JeremyV2014/PlantLifeMonitoringSystem/Diagrams/Breadboard_Top_View.jpg

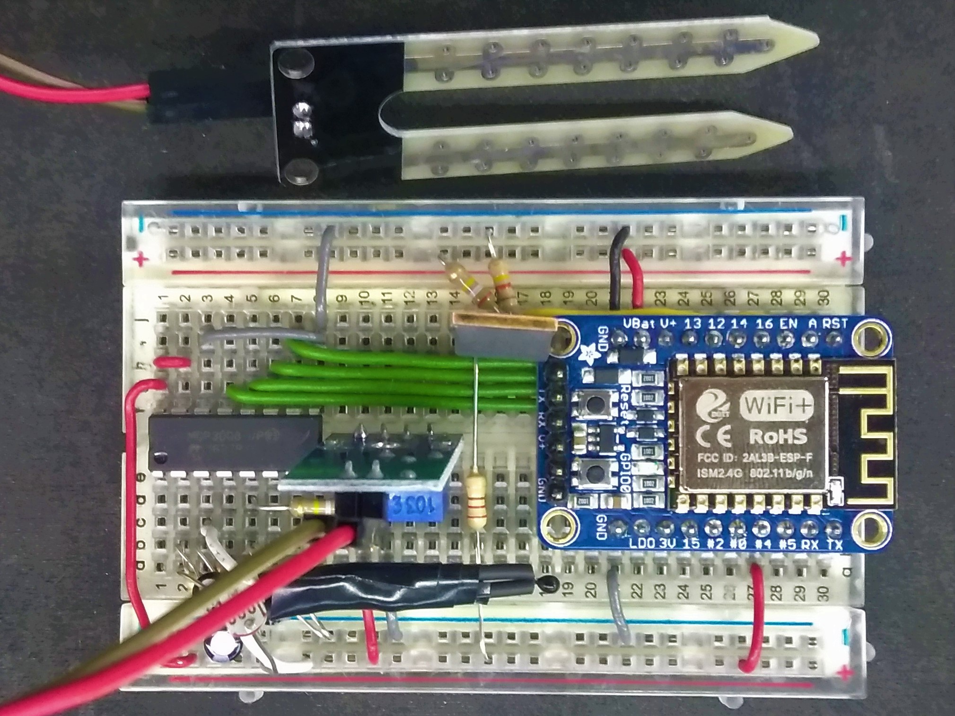
Diagrams/Breadboard_Top_View.jpg
