JeremyV2014/PlantLifeMonitoringSystem/Diagrams/Breadboard_Isometric_View.jpg

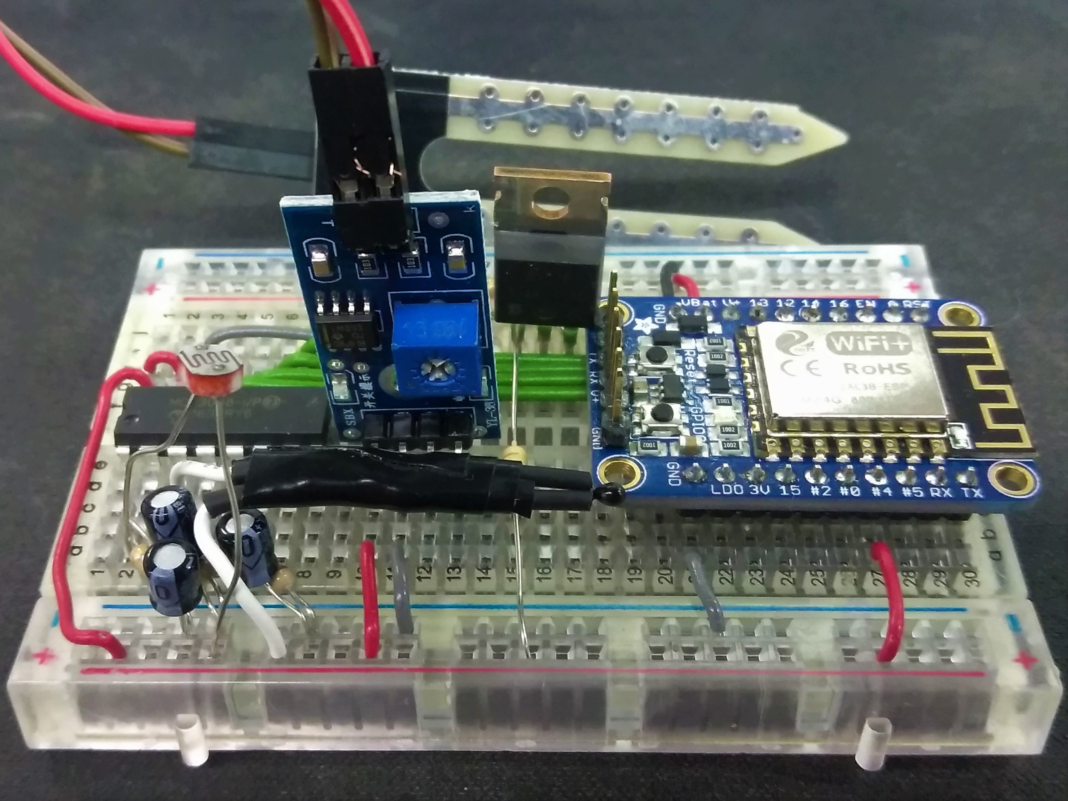
Diagrams/Breadboard_Isometric_View.jpg
