JeremyV2014/PlantLifeMonitoringSystem/Documentation/5_ProjectPoster.pdf

# Plant Life Monitoring System

## Jeremy Maxey-Vesperman, Zachary Goldasich | Girma Tewolde

Hardware Schematic

System Overview

Software Flowchart

Adafruit Huzzah
ESP8266 MCU

Moisture Sensor
Probe

Moisture Sensor
NMOS for enabling
Photoresistor | battery reading circuit

10-bit SPI ADC
MCP3008

Bus for powering sensors and ADC from GPIO

Thermistor

Breadboard Implementation

Design and implement a low-cost, low-power, wireless sensor package that is capable of monitoring various metrics of indoor plants.

Project Goal | •Low-power 32-bit MCU w/ full WiFi front-end easily connects to any wireless network •Low-cost: Each node under $20 in materials •Calibrated photoresistor to measure light intensity •Thermistor allows for temperature monitoring •Soil moisture sensor measures resistivity of soil to estimate moisture content •Battery life monitoring built-in •SMTP-based plant updates with user- configurable update interval

## Core Features

•Integrate auto-watering capabilities •Create waterproof enclosure for outdoor usage
•Implement mesh network of sensor nodes to extend connection range capabalities •Develop fully-featured mobile app to wrap SMTP update messages for clean display of metrics and allow individual node configuration
•Add solar panel to further extend battery life

## Future Additions

•Sensor Read Mode: 1.172mA (~1 second to read all sensors)
•Transmit Mode: 120mA (~1 minute to Tx) •Deep Sleep Mode: 20µA
•Average consumption: ~2mA with hourly updates
•2200mAh battery gives ~45 day lifespan with hourly updates

## Ultra-Low Power
