JeremyV2014/PlantLifeMonitoringSystem/Documentation/3_Presentation.pdf

# Plant Life Monitoring System

# Gaining root access to your plants

# Conception

## - What is it?

- WiFi-enabled sensor package for indoor plants

## - Why Plant Monitoring? - Home automation is trending - Provide metrics that allow user to better care for their plants

■ Previous experience with frustration of trying to grow strawberries

# Core Features

## - Low-power 32-bit MCU with full WiFi front-end and TCP/IP stack

- Easily connect system to any wireless network and provide updates

## - Low-cost

- Total cost per node under $20

## - Multi-sensor package

- Photoresistor to measure light intensity
- Thermistor to measure temperature
- Soil Moisture Sensor to measure resistivity of soil

## - Battery life monitoring built-in - SMTP-based plant updates

- Common protocol
- Easily integrate data into a more user-friendly mobile/desktop application

# Ultra-Low Power

## - Sensor circuits only powered when needed

- Read all sensors in ~1 sec
- MCP3008 ADC I
max

: 500 µA
- Photoresistor I
max

: 330 µA
- Thermistor I
max

: 330 µA
- Moisture sensor I
max

: 6.346 µA
- Battery voltage Imax

: 6.346 µA
- Total I
max

: 1.173 mA

## - ESP8266 MCU 802.11n Tx Mode: 120 mA (~60 sec. to transmit) - ESP8266 MCU Deep Sleep Mode: 20 µA - Average Consumption: ~2 mA with hourly updates - 2200mAh battery gives ~32 day lifespan with hourly updates

# System Overview

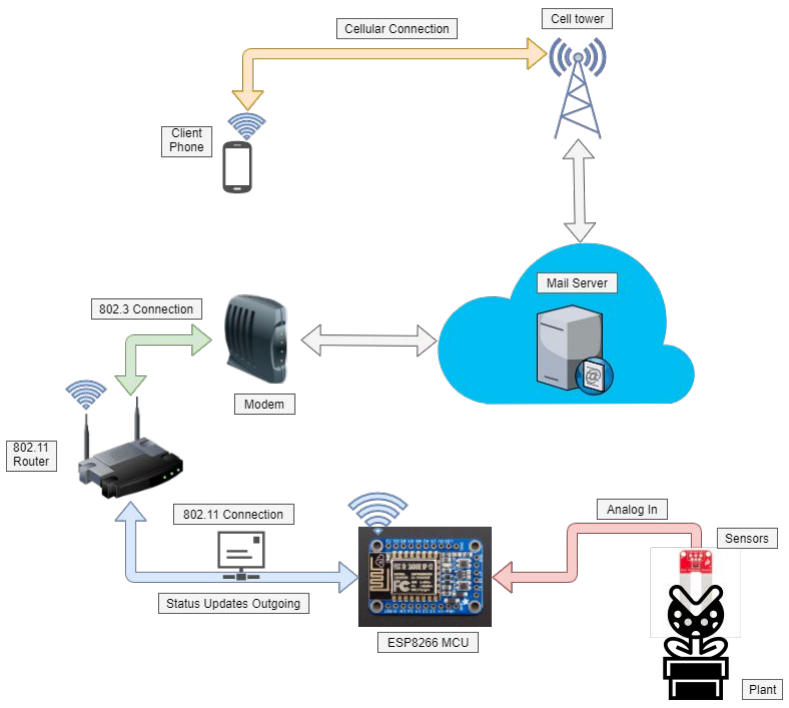
[picture p11: figure]

# Hardware Design

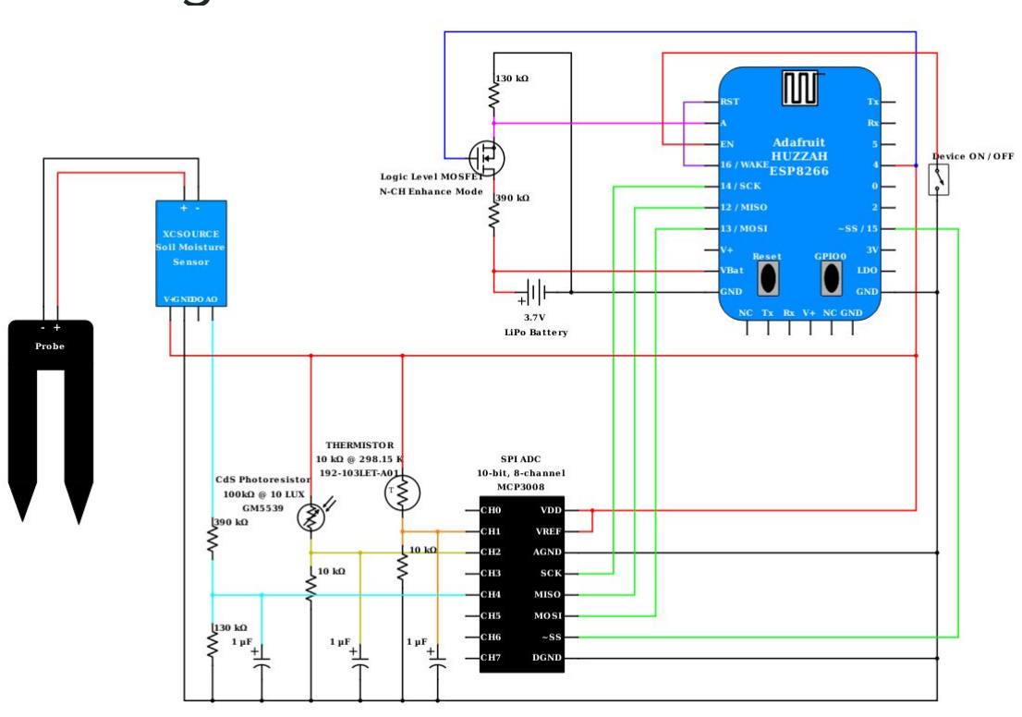
[picture p12: figure]

# Breadboard Implementation

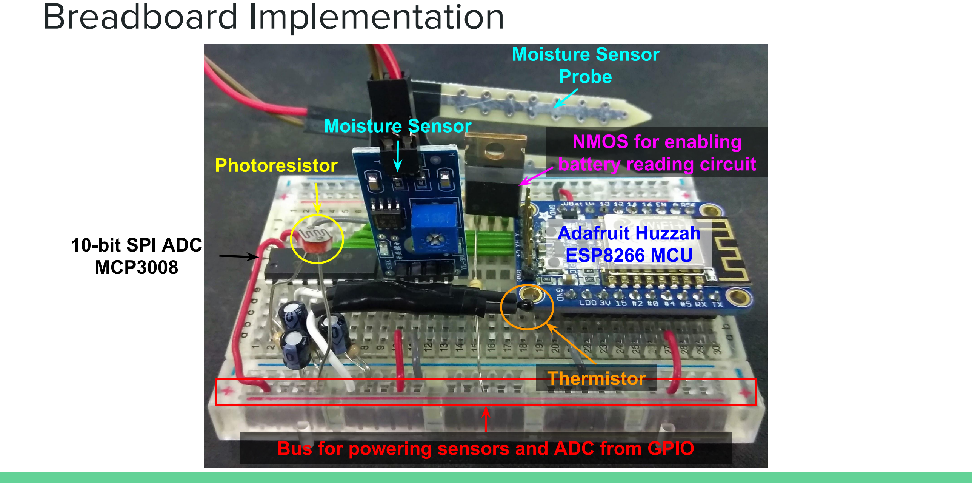
[picture p13: page 7]

Adafruit Huzzah
ESP8266 MCU

Moisture Sensor
Probe

Moisture Sensor
NMOS for enabling
Photoresistor | battery reading circuit

10-bit SPI ADC
MCP3008

Bus for powering sensors and ADC from GPIO

Thermistor

## - ESP8266

- Arduino C

# Software Design

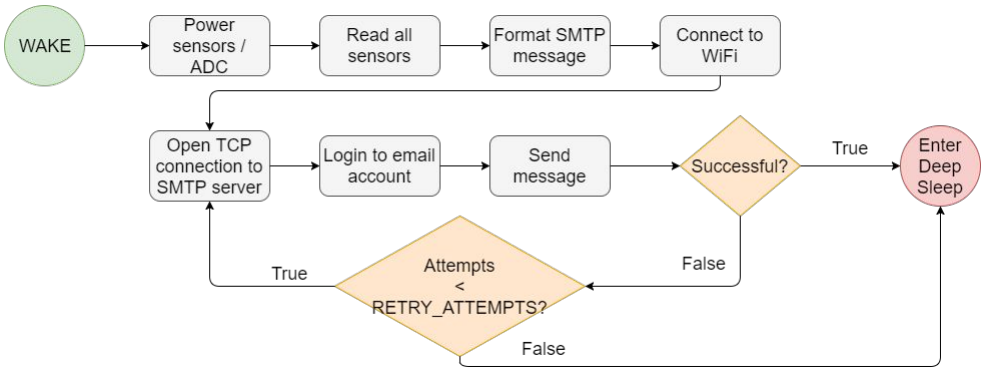
[picture p14: figure]

# Software Design

## - App

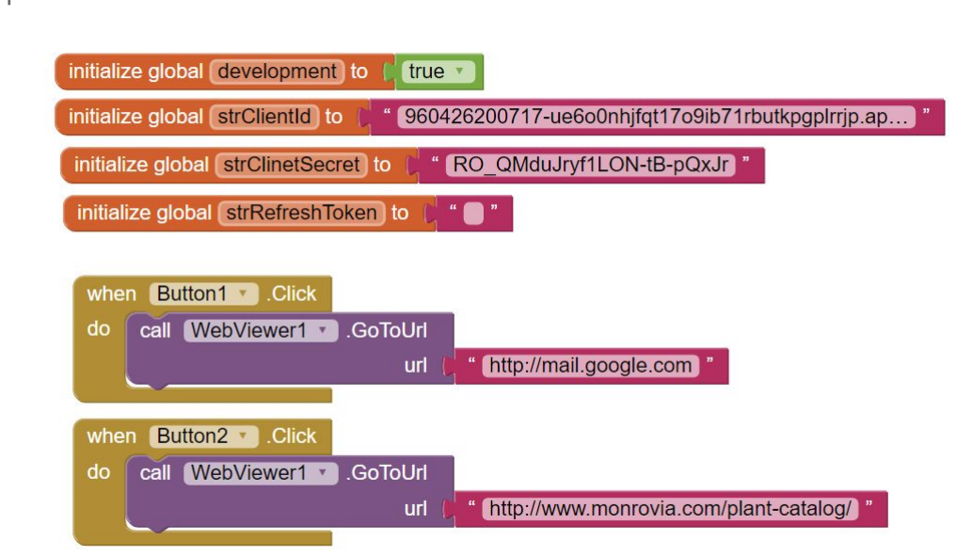
[picture p15: figure]

- MIT App Inventor

# Sample App / Plant Update

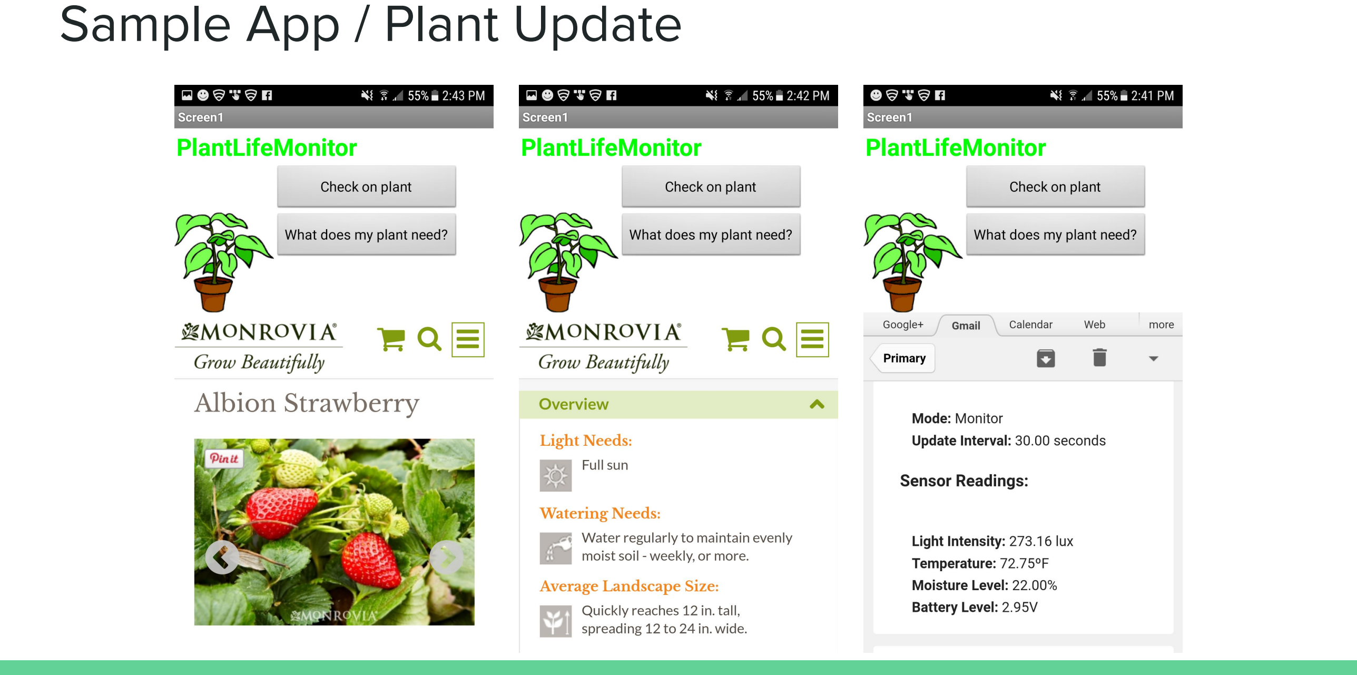
[picture p16: page 10]

# Future Possibilities

## - Integrate auto-watering capabilities - Waterproof case for outdoor usage - Develop mesh network of sensor nodes - Add solar panel to extend battery life - Allow microcontroller to completely shutdown to prevent battery damage - Create fully-featured mobile app

- Neatly display node metrics
- User-updatable settings for individual nodes (update-interval, auto-watering on/off, etc.)
- Display ideal values based on type of plant the node is connected to

## - Desktop app with GUI to initially configure the nodes - OTA software updates

# Questions?

# References

- https://www.digikey.com/en/resources/conversion-calculators/conversion-calculator-battery-life
- http://arduino-esp8266.readthedocs.io/en/latest/index.html
- http://ai2.appinventor.mit.edu/#5442739243843584
- https://www.digikey.com/schemeit/
- https://www.losant.com/blog/making-the-esp8266-low-powered-with-deep-sleep
- http://www.esp8266.com/viewtopic.php?f=32&t=12722
- https://cdn-learn.adafruit.com/downloads/pdf/adafruit-huzzah-esp8266-breakout.pdf
- https://www.allaboutcircuits.com/projects/design-a-luxmeter-using-a-light-dependent-resistor/
- https://sensing.honeywell.com/192-103LET-A01-thermistors
- https://www.allaboutcircuits.com/projects/measuring-temperature-with-an-ntc-thermistor/
- https://cdn-shop.adafruit.com/datasheets/MCP3008.pdf
- http://selfbuilt.net/datasheets/GM55.pdf
- http://www.seattlerobotics.org/encoder/jun97/basics.html
- http://emant.com/316002.page
- https://learn.adafruit.com/photocells/measuring-light
- http://espressif.com/sites/default/files/documentation/0a-esp8266ex_datasheet_en.pdf
