JeremyV2014/PlantLifeMonitoringSystem/Diagrams/Hardware_Schematic.png

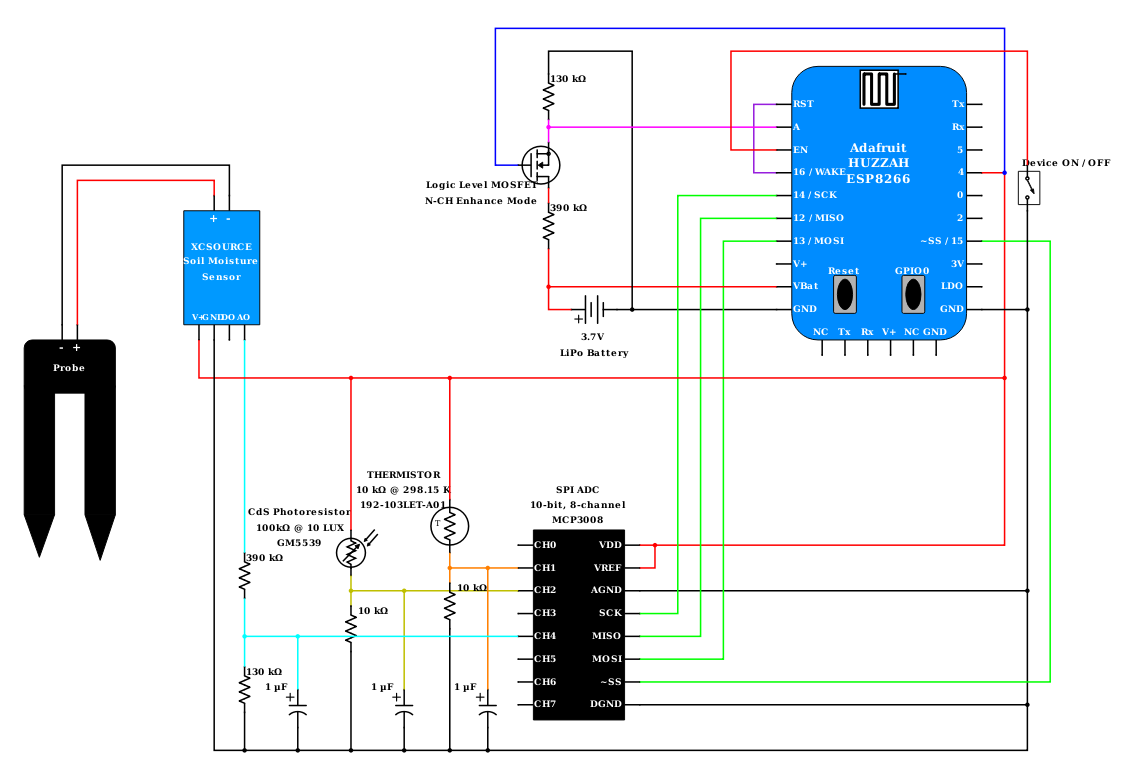
Diagrams/Hardware_Schematic.png
