JeremyV2014/PlantLifeMonitoringSystem/Diagrams/Sample_Email_Update.png

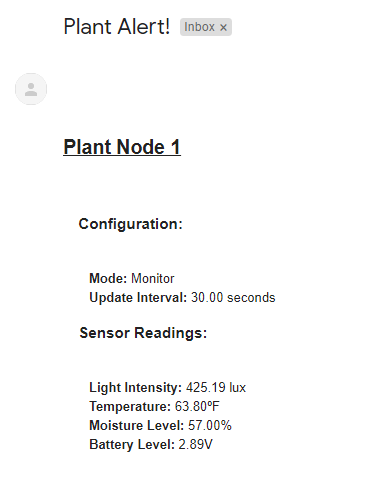
Diagrams/Sample_Email_Update.png
