JeremyV2014/PlantLifeMonitoringSystem/Diagrams/Software_Flowchart.png

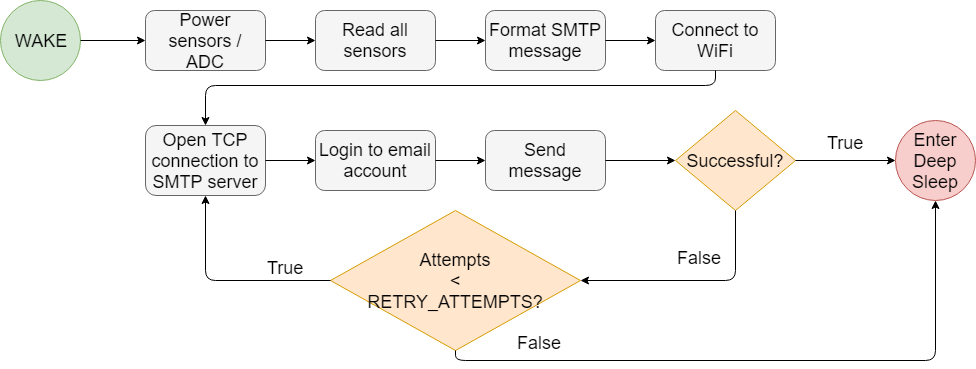
Diagrams/Software_Flowchart.png
