JeremyV2014/PlantLifeMonitoringSystem/(commit log)

2018-10-16 Initial Commit
    Initial project commit. Represents the status of the project after submitting final report.
    [Sensor_Formulas.xlsx]
2018-10-16 Sample Email Screenshot
    Added screenshot of a sample email.
